Brunner-neutrino-lab/IV-MUX-public/KiCAD/User Library-CBBJ70.step

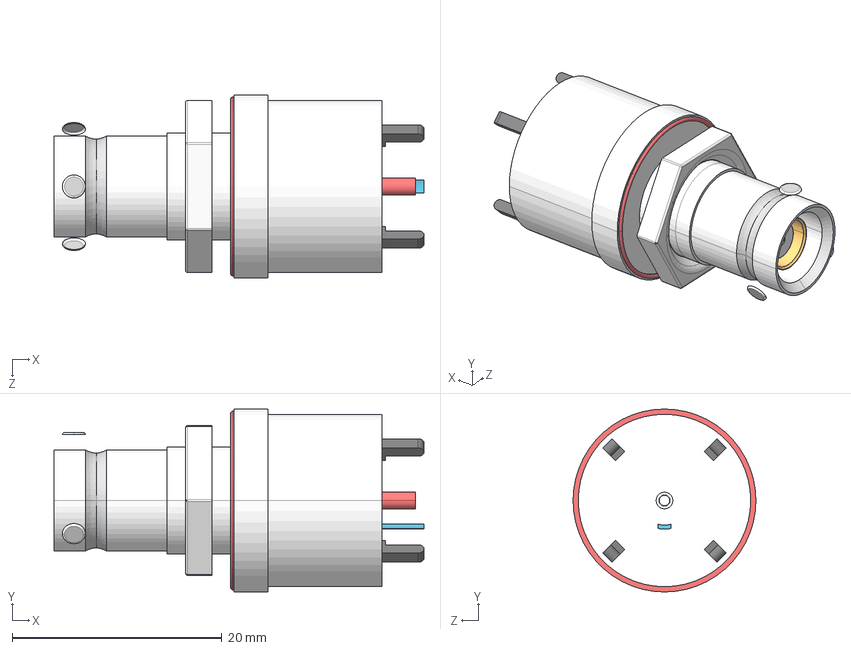
[picture p2: CAD file, 2024-08-08]
KiCAD/User Library-CBBJ70.step
35.3 x 17.4 x 17.4 mm
