Brunner-neutrino-lab/IV-MUX-public/KiCAD/73366-0061_stp/733660061.stp

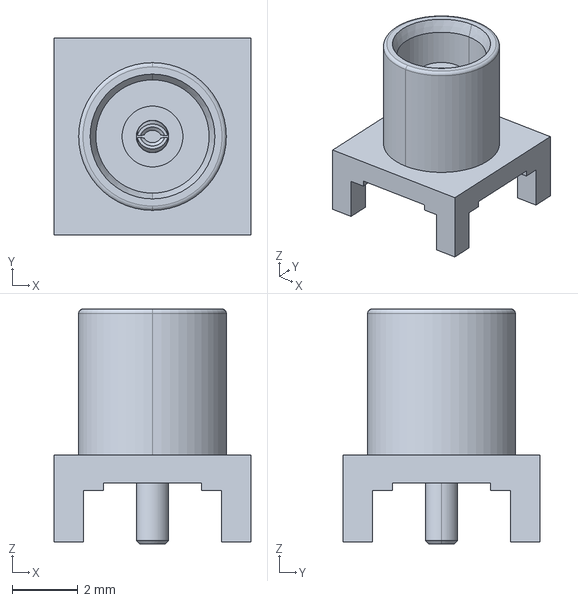
[picture p3: CAD file, 2024-08-08]
KiCAD/73366-0061_stp/733660061.stp
6.00 x 6.00 x 7.16 mm
