Brunner-neutrino-lab/IV-MUX-public/KiCAD/iv-mux.kicad_pcb

## KiCad design KiCAD/iv-mux.kicad_pcb (2024-08-08)

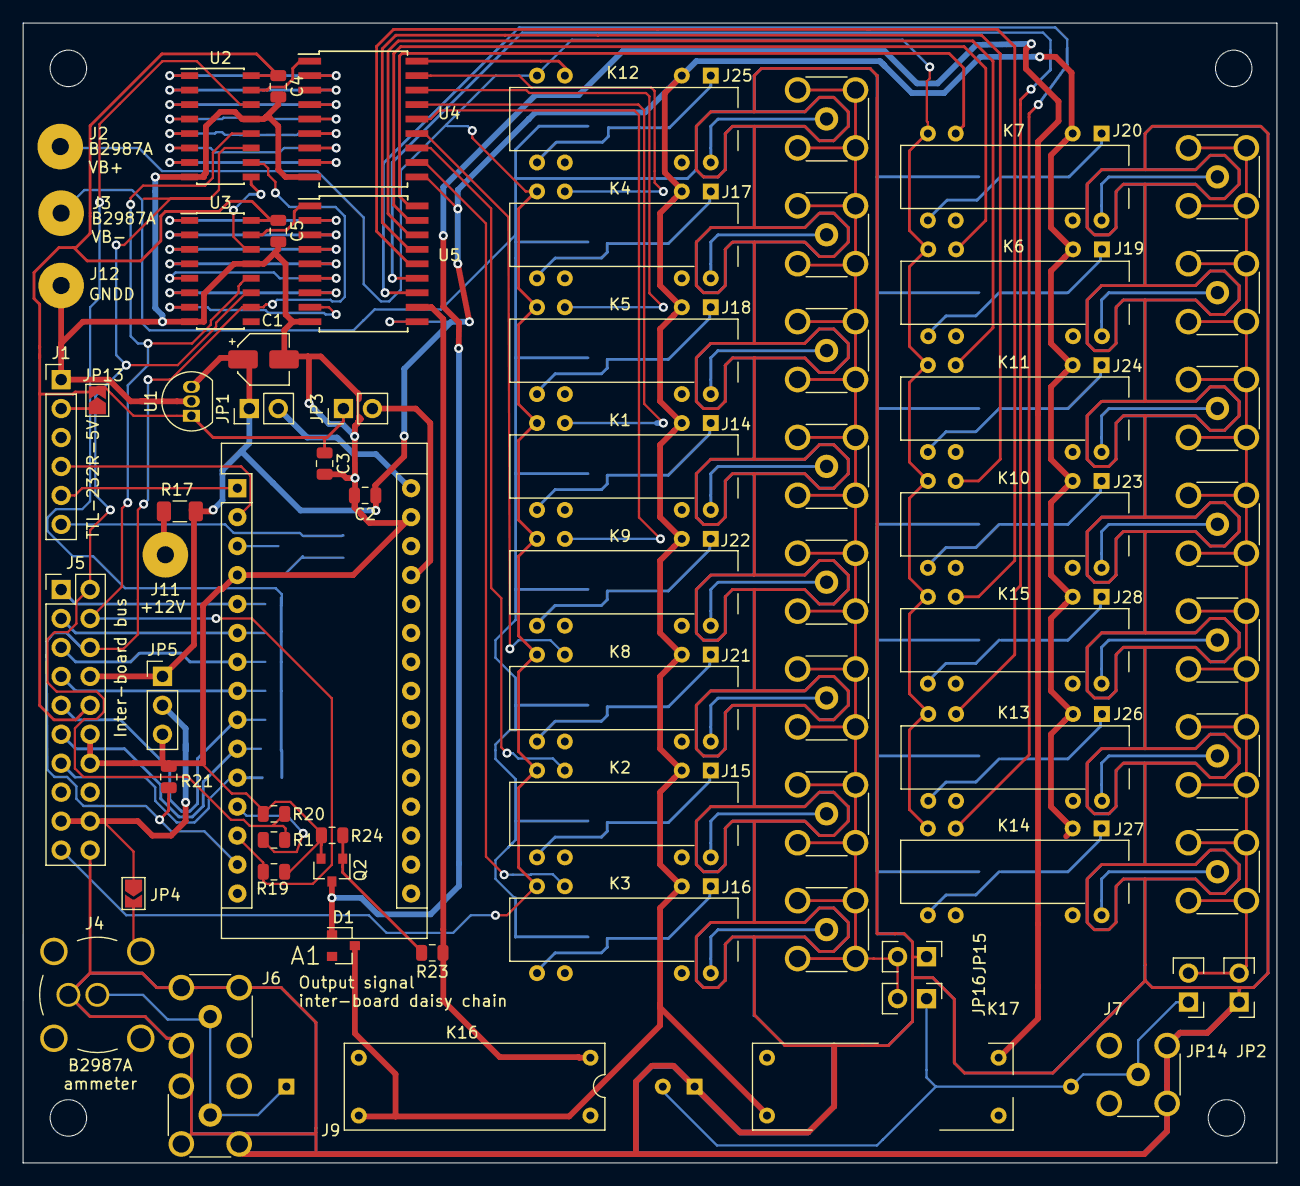
[picture p23: board iv-mux.kicad_pcb from above]

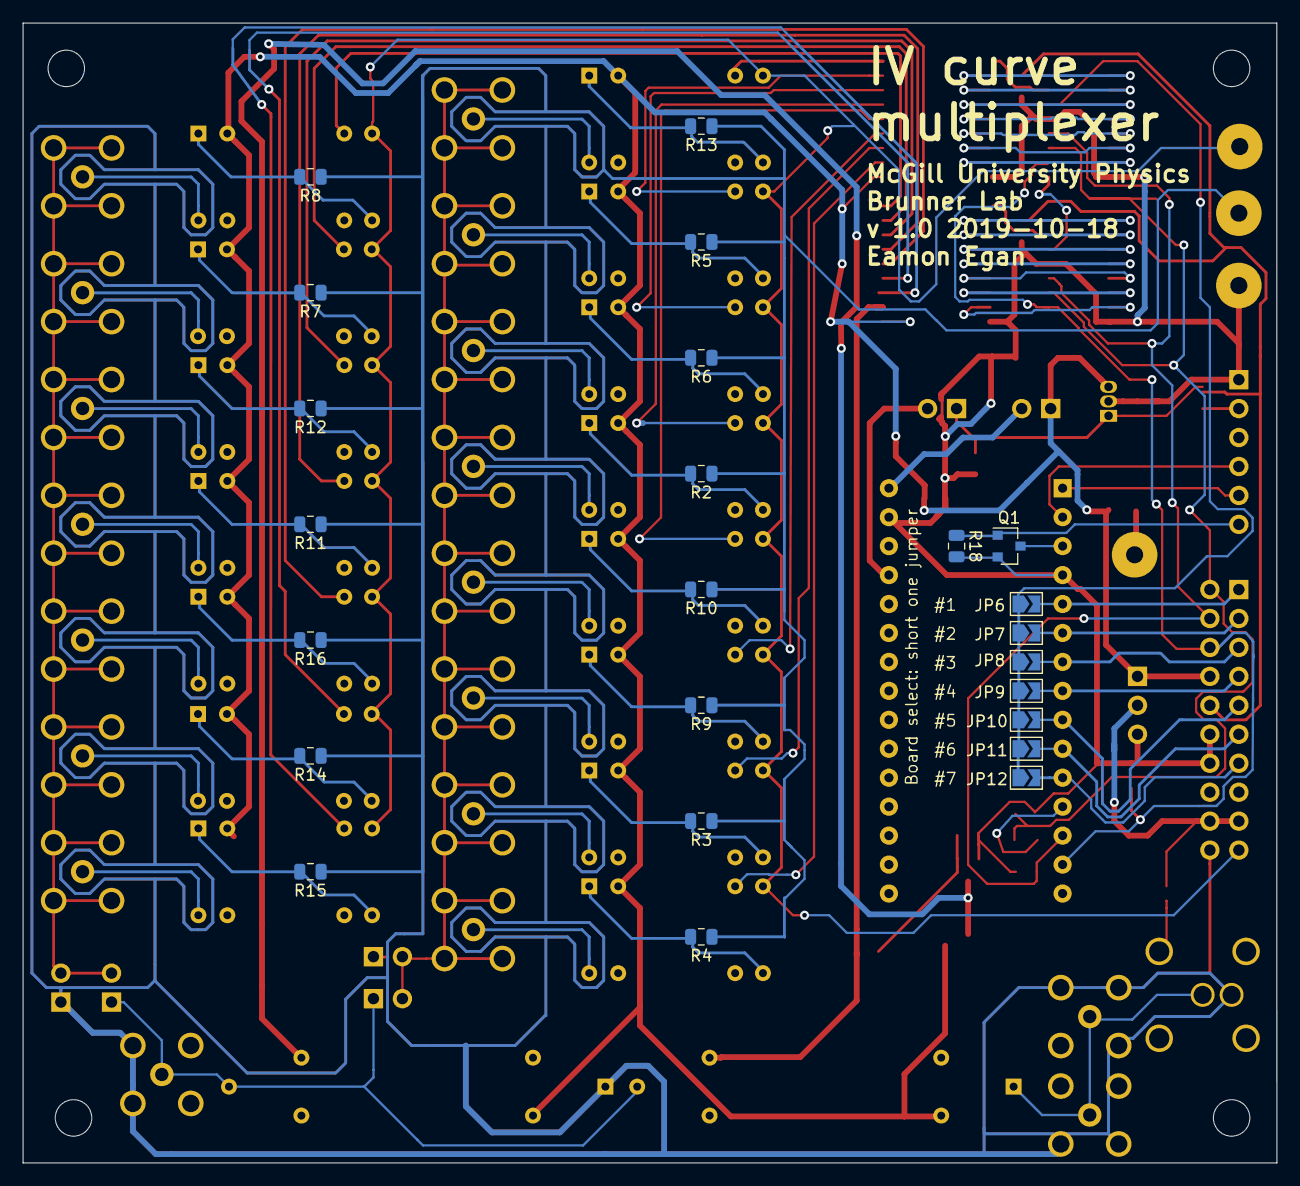
[picture p24: board iv-mux.kicad_pcb from below]

Board: 2 copper layers, 110.0 x 100.0 mm, 95 parts (24 on the bottom side), 96 nets.

Parts:
A1: Arduino_Nano_v3.x; Arduino_Nano
C1: CP; CP_Elec_4x3
C2: C; C_0805_2012Metric
C3, C4, C5: 0.1uF; C_0805_2012Metric
D1: BAV70; SOT-23
J1: Conn_01x06_Male; PinHeader_1x06_P2.54mm_Vertical
J2, J3, J11, J12: Conn_01x01_Female; SolderWirePad_1x01_Drill1.5mm
J4: Conn_Triax; BNC_coax_or_triax
J5: Conn_02x10_Odd_Even; PinHeader_2x10_P2.54mm_Vertical
J6, J7, J9, J14, J15, J16, J17, J18, J19, J20, J21, J22, J23, J24, J25, J26, J27, J28: Conn_Coaxial; MCX_Vertical
JP1, JP2, JP3, JP14, JP15, JP16: Jumper_2_Open; PinHeader_1x02_P2.54mm_Vertical
JP4, JP6, JP7, JP8, JP9, JP10, JP11, JP12, JP13: Jumper_2_Open; SolderJumper-2_P1.3mm_Open_TrianglePad1.0x1.5mm
JP5: Jumper_3_Open; PinHeader_1x03_P2.54mm_Vertical
K1, K2, K3, K4, K5, K6, K7, K8, K9, K10, K11, K12, K13, K14, K15: DIP12-2A72-21D; Relay_StandexMeder_DIP_HighProfile_SSmod
K16, K17: HI12-1A85; Relay_StandexMeder_HI
Q1, Q2: 2N7002; SOT-23
R1, R2, R3, R4, R5, R6, R7, R8, R9, R10, R11, R12, R13, R14, R15, R16, R18, R19, R20, R21, R23, R24: R_US; R_0805_2012Metric
R17: R_US; R_1206_3216Metric
U1: L78L05_TO92; TO-92_Inline
U2, U3: 74HC595; SOIC-16_3.9x9.9mm_P1.27mm
U4, U5: ULN2803A; SOIC-18W_7.5x11.6mm_P1.27mm

Connections:
+5V: C3.1, C4.1, C5.1, J5.10, JP3.1, JP13.2, U1.1, U2.16, U3.16
+12V: C1.1, C2.1, D1.3, J5.8, JP1.1, JP5.1, K1.2, K2.2, K3.2, K4.2, K5.2, K6.2, K7.2, K8.2, K9.2, K10.2, K11.2, K12.2, K13.2, K14.2, K15.2, K16.3, K17.3, R17.1, U1.3, U4.10, U5.10
/BIAS RELAYS/BG_OR_SENSE_A: J14.2, J15.2, J16.2, J17.2, J18.2, J21.2, J22.2, J25.2, JP15.2, JP16.2
/BIAS RELAYS/BG_OR_SENSE_B: J19.2, J20.2, J23.2, J24.2, J26.2, J27.2, J28.2, JP2.2, JP14.2
/FTDI_RXD: A1.1, J1.5
/FTDI_TXD: A1.2, J1.4
/SER: JP6.1, JP7.1, JP8.1, JP9.1, JP10.1, JP11.1, JP12.1, U2.14
/SER1: A1.5, J5.1, JP6.2
/SER2: A1.6, J5.3, JP7.2
/SER3: A1.7, J5.5, JP8.2
/SER4: A1.8, J5.7, JP9.2
/SER5: A1.9, J5.9, JP10.2
/SER6: A1.10, J5.11, JP11.2
/SER7: A1.11, J5.13, JP12.2
/Sheet5DB1B453/RCLK: A1.13, J5.4, R19.1, U2.12, U3.12
/Sheet5DB1B453/SRCLK: J5.2, R1.2, R20.1, U2.11, U3.11
/Sheet5DB1B453/~BIAS_ON0: K12.6, U4.18
/Sheet5DB1B453/~BIAS_ON1: K4.6, U4.17
/Sheet5DB1B453/~BIAS_ON2: K5.6, U4.16
/Sheet5DB1B453/~BIAS_ON3: K1.6, U4.15
/Sheet5DB1B453/~BIAS_ON4: K9.6, U4.14
/Sheet5DB1B453/~BIAS_ON5: K8.6, U4.13
/Sheet5DB1B453/~BIAS_ON6: K2.6, U4.12
/Sheet5DB1B453/~BIAS_ON7: K3.6, U4.11
/Sheet5DB1B453/~BIAS_ON8: K7.6, U5.18
/Sheet5DB1B453/~BIAS_ON9: K6.6, U5.17
/Sheet5DB1B453/~BIAS_ON10: K11.6, U5.16
/Sheet5DB1B453/~BIAS_ON11: K10.6, U5.15
/Sheet5DB1B453/~BIAS_ON12: K15.6, U5.14
/Sheet5DB1B453/~BIAS_ON13: K13.6, U5.13
/Sheet5DB1B453/~BIAS_ON14: K14.6, U5.12
/Sheet5DB1B453/~SRCLR: A1.14, J5.6, R21.1, U2.10, U3.10
/VB+: J2.1, J5.19, K1.7, K2.7, K3.7, K4.7, K5.7, K6.7, K7.7, K8.7, K9.7, K10.7, K11.7, K12.7, K13.7, K14.7, K15.7
/VB-: J3.1, J4.3, J5.20, J6.2, J7.2, J9.2, JP2.1, JP15.1, K17.1, R2.1, R3.1, R4.1, R5.1, R6.1, R7.1, R8.1, R9.1, R10.1, R11.1, R12.1, R13.1, R14.1, R15.1, R16.1
/sheet5DD0BE42/ON: D1.1, K17.5, Q2.3
/sheet5DD0BE42/SENSE_DIRECT: J7.1, JP14.1, JP16.1, K16.2, K17.2
/sheet5DD0BE42/SENSE_SWITCHED: J4.1, J6.1, J9.1, K16.1
/sheet5DD0BE42/~ON: K16.5, R23.1, U5.11
GNDA: J5.17, J5.18, JP4.1, JP5.2
GNDD: A1.4, A1.29, C1.2, C2.2, C3.2, C4.2, C5.2, J1.1, J5.12, J5.14, J12.1, JP5.3, Q1.2, Q2.2, R18.2, R19.2, R20.2, R21.2, R24.2, U1.2, U2.8, U2.13, U3.8, U3.13, U4.9, U5.9
unnamed: A1.3, Q1.3
unnamed: A1.12, R1.1
unnamed: A1.27, JP3.2
unnamed: A1.30, JP1.2
unnamed: J1.2, JP13.1
unnamed: J1.6, Q1.1, R18.1
unnamed: J4.2, JP4.2
unnamed: J11.1, R17.2
unnamed: J14.1, K1.14
unnamed: J15.1, K2.14
unnamed: J16.1, K3.14
unnamed: J17.1, K4.14
unnamed: J18.1, K5.14
unnamed: J19.1, K6.14
unnamed: J20.1, K7.14
unnamed: J21.1, K8.14
unnamed: J22.1, K9.14
unnamed: J23.1, K10.14
unnamed: J24.1, K11.14
unnamed: J25.1, K12.14
unnamed: J26.1, K13.14
unnamed: J27.1, K14.14
unnamed: J28.1, K15.14
unnamed: K1.1, K1.8, R2.2
unnamed: K2.1, K2.8, R3.2
unnamed: K3.1, K3.8, R4.2
unnamed: K4.1, K4.8, R5.2
unnamed: K5.1, K5.8, R6.2
unnamed: K6.1, K6.8, R7.2
unnamed: K7.1, K7.8, R8.2
unnamed: K8.1, K8.8, R9.2
unnamed: K9.1, K9.8, R10.2
unnamed: K10.1, K10.8, R11.2
unnamed: K11.1, K11.8, R12.2
unnamed: K12.1, K12.8, R13.2
unnamed: K13.1, K13.8, R14.2
unnamed: K14.1, K14.8, R15.2
unnamed: K15.1, K15.8, R16.2
unnamed: Q2.1, R23.2, R24.1
unnamed: U2.1, U4.2
unnamed: U2.2, U4.3
unnamed: U2.3, U4.4
unnamed: U2.4, U4.5
unnamed: U2.5, U4.6
unnamed: U2.6, U4.7
unnamed: U2.7, U4.8
unnamed: U2.9, U3.14
unnamed: U2.15, U4.1
unnamed: U3.1, U5.2
unnamed: U3.2, U5.3
unnamed: U3.3, U5.4
unnamed: U3.4, U5.5
unnamed: U3.5, U5.6
unnamed: U3.6, U5.7
unnamed: U3.7, U5.8
unnamed: U3.15, U5.1
